montana-science-center/exhibit-optical-communications/pcb/mic_preamp/mic_preamp.png

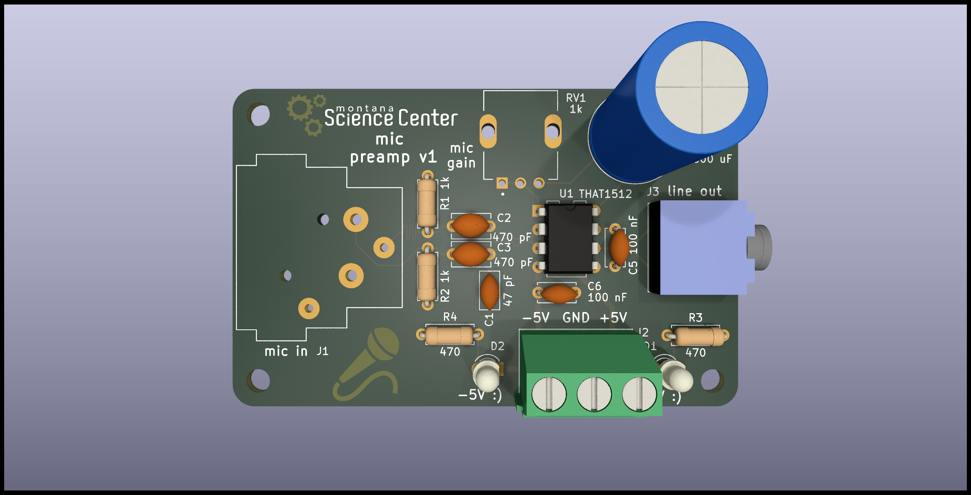
pcb/mic_preamp/mic_preamp.png
