montana-science-center/exhibit-optical-communications/pcb/led_modulator/led_modulator.png

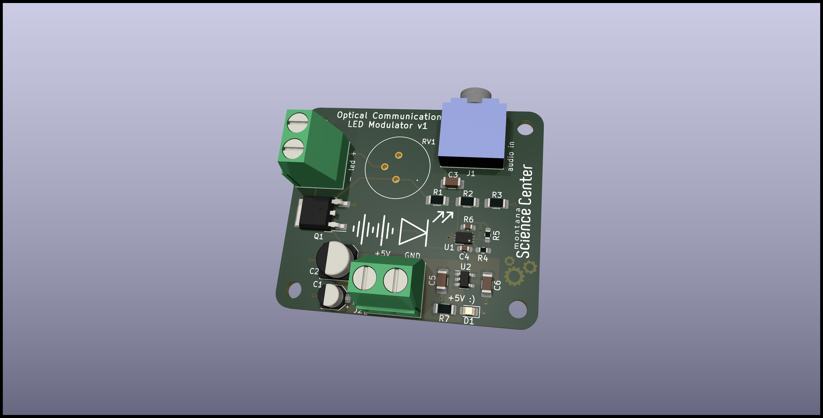
pcb/led_modulator/led_modulator.png
