montana-science-center/exhibit-optical-communications/README.md

# exhibit-optical-communications
Optical telecomunnications exhibit
