montana-science-center/exhibit-optical-communications/pcb/mic_preamp/mic_preamp_schematic.pdf

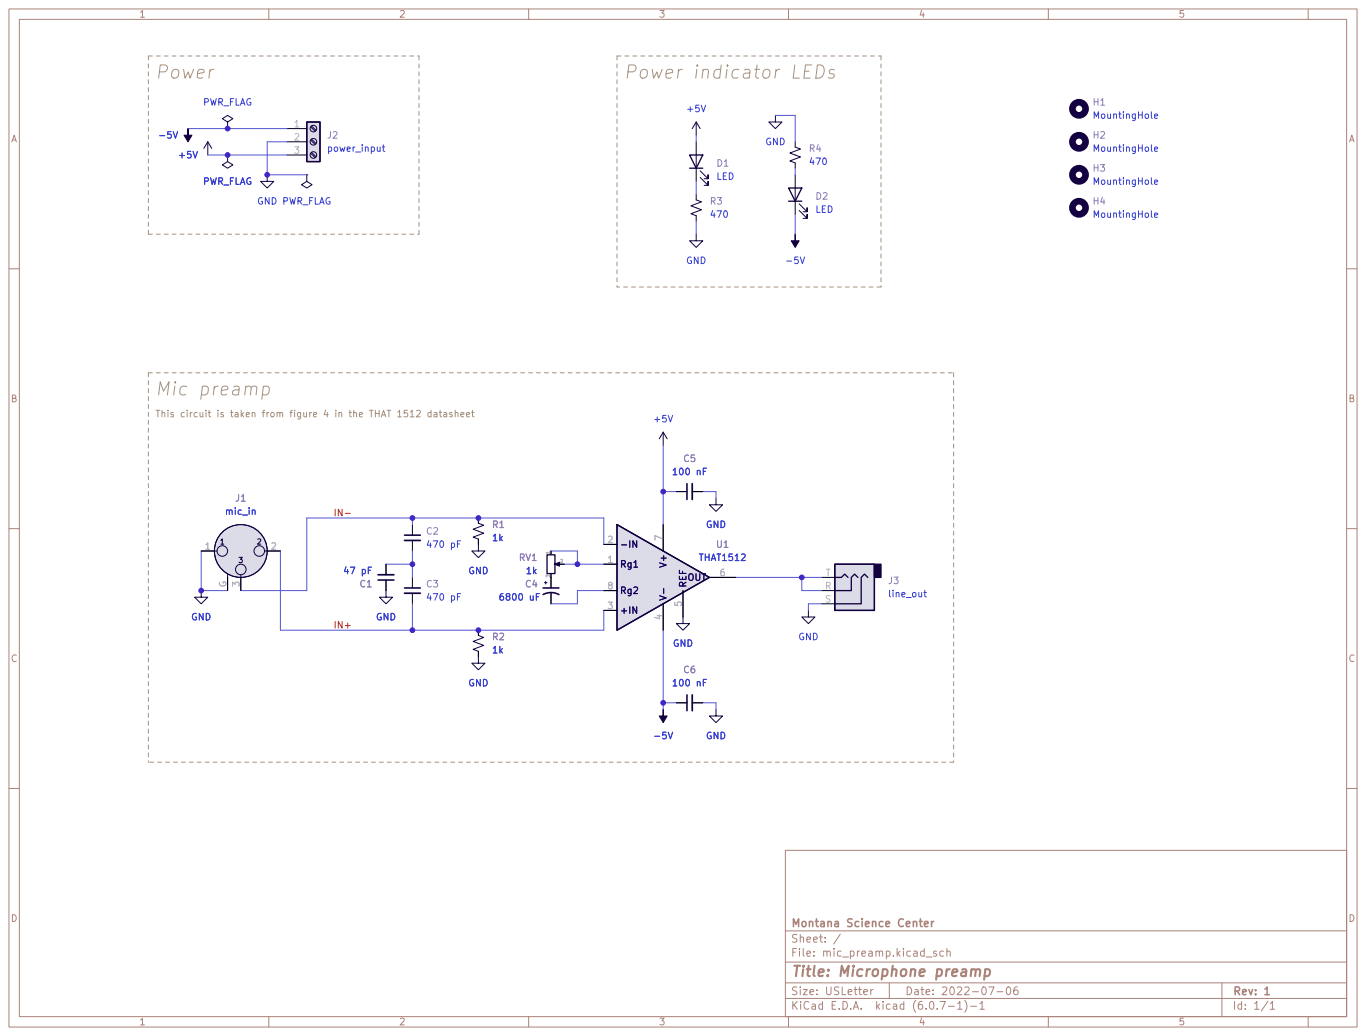
[picture p3: page 1]

IN+ This circuit is taken from figure 4 in the THAT 1512 datasheet

File: mic_preamp.kicad_sch Sheet: / Montana Science Center

Id: 1/1 Title: Microphone preamp
