montana-science-center/exhibit-optical-communications/pcb/bpf/bpf-schematic.pdf

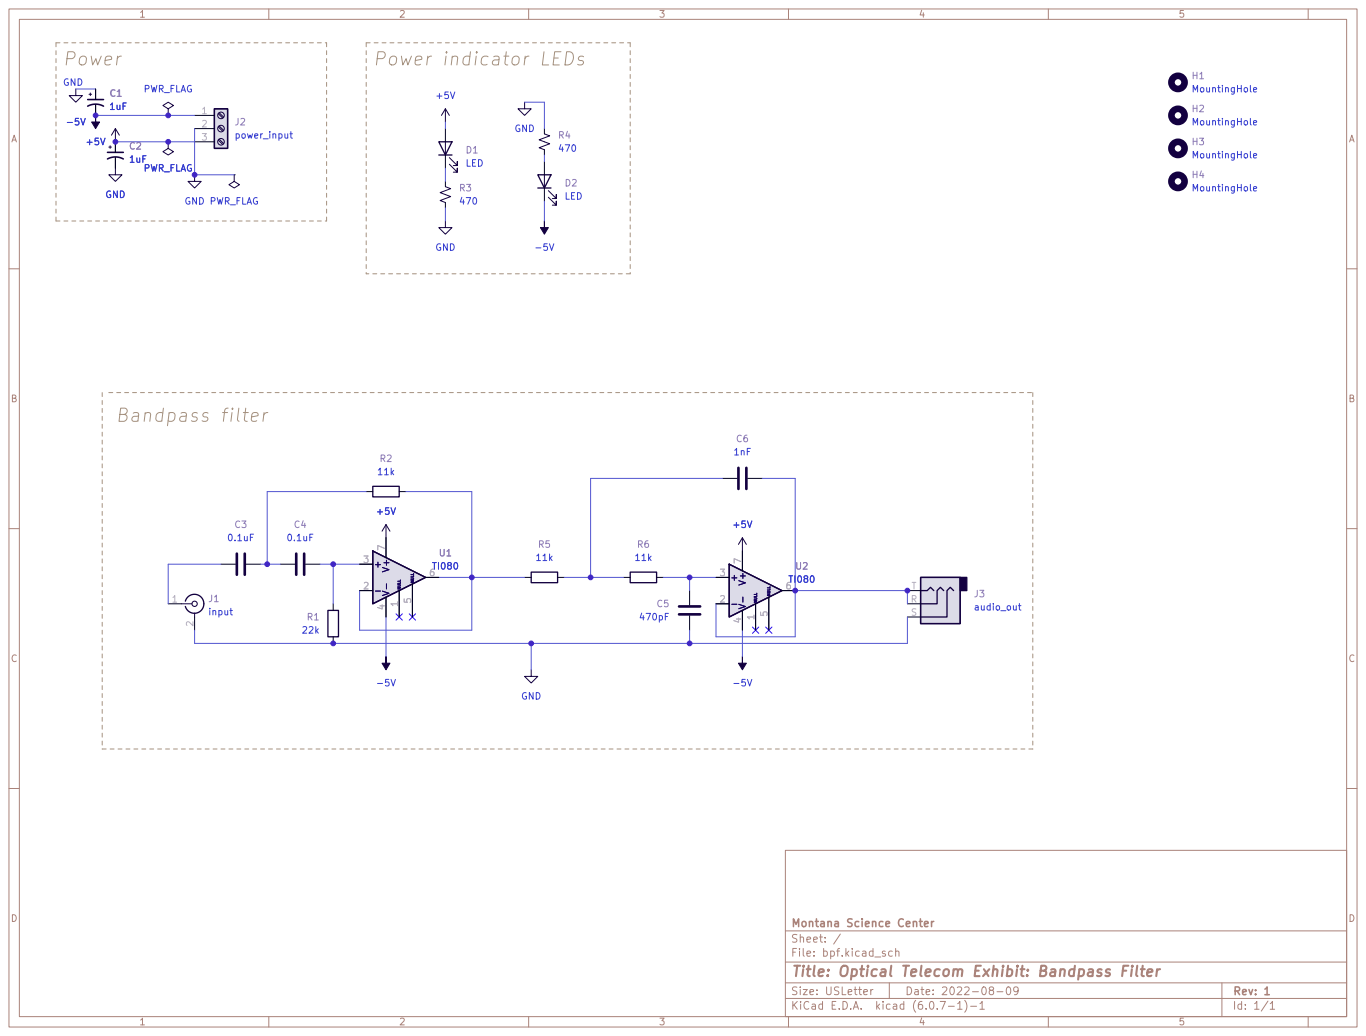
[picture p4: page 1]

File: bpf.kicad_sch Sheet: / Montana Science Center

Id: 1/1 Title: Optical Telecom Exhibit: Bandpass Filter
