montana-science-center/exhibit-optical-communications/(commit log)

2022-07-07 part libraries for mic preamp circuit
2022-07-07 mic preamp schematic
    [mic_preamp.kicad_pcb, mic_preamp.kicad_sch]
2022-07-09 mic preamp pcb layout
    [mic_preamp.kicad_pcb, mic_preamp.kicad_sch]
2022-07-14 finalize mic preamp pcb layout
    [mic_preamp.kicad_pcb]
2022-08-10 bpf schematic; need to update cap footprints
    [bpf.kicad_pcb, bpf.kicad_sch]
2022-08-10 initial component placement
    [bpf.kicad_pcb]
2022-08-11 finalize layout and routing
    [bpf.kicad_pcb, bpf.kicad_sch]
2022-08-11 fix mounting hole footprint
    [mic_preamp.kicad_sch]
2022-08-11 3d model for BNC connector
2022-08-14 pwm IC lib
2022-08-14 silkscreen graphics for fun
2022-08-14 LED modulator PCB
    [led_modulator.kicad_pcb, led_modulator.kicad_sch]
2022-08-15 add power indicator; update footprints
    [led_modulator.kicad_pcb, led_modulator.kicad_sch]
2022-08-15 add silkscreen for JLC order number
    [bpf.kicad_pcb, led_modulator.kicad_pcb, mic_preamp.kicad_pcb]
2022-08-15 add gerbers
    [bpf-B_Cu.gbl, bpf-B_Mask.gbs, bpf-B_Paste.gbp, bpf-B_Silkscreen.gbo, bpf-Edge_Cuts.gm1, bpf-F_Cu.gtl, bpf-F_Mask.gts, bpf-F_Paste.gtp]
2022-08-15 add preamp schematic
2022-08-31 change C4 to polarized footprint
    [mic_preamp.kicad_pcb, mic_preamp.kicad_sch]
2022-08-31 update to v2
    [mic_preamp.kicad_pcb, mic_preamp.kicad_sch]
